RobotekOrleans/CFR2027/Project gestion/functional analysis/Capella/[OAB] Operational Entities.jpg

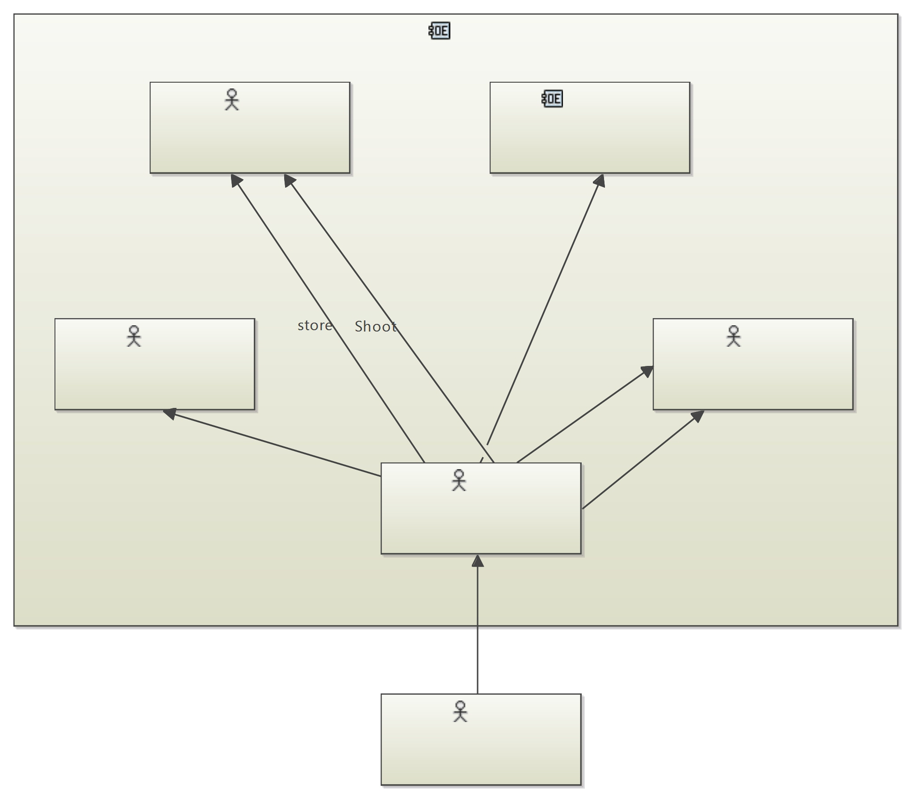
Project gestion/functional analysis/Capella/[OAB] Operational Entities.jpg
