RobotekOrleans/CFR2027/Project gestion/Functionnal Analisys/Project_gestion_OAB.png

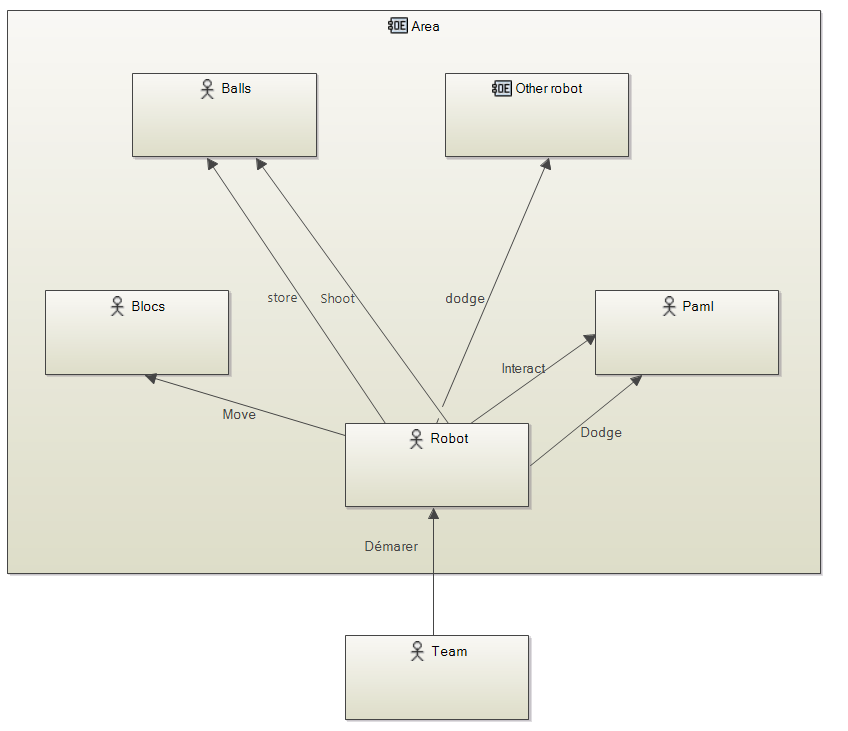
Project gestion/Functionnal Analisys/Project_gestion_OAB.png
