RobotekOrleans/CFR2027/README.md

# French Robotics Cup — Robotek Orléans

## About

This project was initiated by Robotek Orléans to design and build an autonomous robot for the French Robotics Cup (Coupe de France de Robotique), organized under the Eurobot framework.

The goal of the project is to participate at the eurobot competition, for that we need to build a fully autonomous robot capable of performing specific tasks defined in the official rules. The organizers grant complete freedom regarding the robot's structure, mechanical design, and actuation systems. The first requirement is to successfully pass the homologation phase by adhering strictly to the official competition regulations.

- Project Manager: Maxime Fabre

---

## The Robot

The robot features a square-shaped base chassis.

WIP Full Assembly

### Getting Started

1. Connect the battery to the main power connector.

2. The robot will power on and start up automatically.

---

## Repository Structure

The project files are structured as follows:

- [regulation-file](./Regulations%20file/) — Rules, documentation, and resources provided by the Eurobot / French Robotics Cup organizers.

- [Project management](./Project%20management/) — Project tracking, planning, risk analysis, and management resources.

- [Software](./Software/) — Embedded source code, control algorithms, software architecture, and setup guides.

- [Hardware](./Hardware/) — CAD models, 3D printing files, PCB designs, and electrical schematics.

---

## Team & Section Leads

- Project Manager: Maxime Fabre

- Software Lead: Maxime Fabre

- Hardware Lead: Thibaut Martin

- Project Management Lead: Mickaël Borges
