RobotekOrleans/CFR2027/Hardware/README.md

# Hardware - Robotek Orléans

## About

This directory contains the complete hardware development files for the robot, covering its full mechanical structure, electrical schematics, and design decisions.

- Hardware Team Lead: Thibaut Martin

---

## Robot

WIP Full Assembly

## Directory Structure

The Hardware repository is organized into three main categories:

### 1. Mechanical Assembly ([mechanical](./mechanical/) )

Contains images and descriptions of the physical assembly, along with material selections and technical justifications for the structural design choices.

- Section Lead: Thibaut Martin

### 2. CAD & 3D Modeling ([CAD](./cad/) )

Contains 3D assembly models and printable components. 3D modeling enables rapid prototyping of complex geometries with adaptable strength based on material choice and infill settings.

- Section Lead: Mickaël Borges

### 3. Electronics & Schematics (([electronics](./electronics/) ))

Contains electrical schematics, wiring diagrams for the mobile base and actuators, as well as custom PCB layout files.

- Section Lead: Ryan Gedoir
