RobotekOrleans/CFR2027/Hardware/CAO/README.md

# CAD & Hardware - Robotek Orléans

## About

This section contains all 3D CAD modeling files for the robot's mechanical components. 3D modeling allows us to visualize the design clearly, check for potential mechanical constraints, and identify any assembly issues prior to manufacturing.

### Directory Structure

* **`full-assembly/`** *(or `name/`)* — Contains the complete 3D assembly model of the robot.
* **Subfolders** — Dedicated directories for each individual mechanical component and subsystem.

### CAD & 3D Printing Setup

* **CAD Software:** Autodesk Fusion 360

* **3D Printer:** Bambu Lab X1 Carbon

* **Materials:** PLA & PETG (the specific filament used for each component is noted in its description)
---

## Components

### Standoffs (`Standoffs/`)

The robot structure relies on 4 main pillars, held together by threaded rods running through their center. Custom PLA pillars were 3D printed to distribute the structural load across a larger surface area compared to the threaded rods alone.

* **Location:** `Standoffs/`
* **Material:** PLA
* **Filament Used:** ~239.6 g

---

### Motor Mounts (`Motor_support/`)

The robot is driven by 4 motors. Custom PLA mounting brackets were designed and 3D printed to secure the motors to the frame.

* **Location:** `support-moteur/`
* **Material:** PLA
* **Filament Used:** ~72.6 g

---

### Pump Mounts (`support-pompe/`)

The robot uses 4 vacuum/air pumps. Dedicated mounting brackets were 3D printed to securely fasten the pumps to the structure.

* **Location:** `support-pompe/`
* **Material:** PLA
* **Filament Used:** N/A *(To be determined)*
