RobotekOrleans/CFR2027/Software/Liste des pins ESP32.odt

Branchement ESP32

- Capteurs ultrasons : 5 broches.

4 Echo sur GPIO 34, 35, 36, 39 : input only

1. Trigger pour tous les capteurs : GPIO 23
- Ponts en H : 10 broches. GPIO 27, 25, 18, 21 (PWM 1 à 4), GPIO 26, 33, 19, 22 (DIR 1 à 4), GPIO 13 (STBY commun)
- Encodeurs moteurs : 4 broches.

1 seule phase par encodeur pour connaitre la vitesse, le sens de rotation on le connait déjà. GPIO 4, 14, 32, 15

- Communication Pi 4 : 2 broches (UART TX/RX).

GPIO 16 (RX2), GPIO 17 (TX2)

Total = 20 broches.
