RobotekOrleans/CFR2027/Report/Personal_Feedback_n1_Thibaut_MARTIN.docx

# Personal Feedback n°1

# Task completed

## Project specifications

With Rayan I highlighted all the project’s specification and organised them in a table. To specify every function we named them and split them in two : Critical function and Principal function. With that everyone in the project’s can effectively know what our robot must do and can do.
