RobotekOrleans/CFR2027/Project management/Report/grille eval PDR 4A S7 GPSE template(1).xlsx

 |  | Débutant |  | Novice | 0-6 | 4A PDR Projet GPSE S7 (ver : 16/10/2026)
 |  | En développement |  |  | 7-11 | Projet :
 |  | Compétent |  |  | 12-15 | Tutor:
 |  | Avancé |  |  | 16-20 | Commentaires
Elèves |  | Elève A | Elève B | Elève C | Elève D
C4 : Gérer un développement projet dans une approche système
Analyser le besoin opérationnel
● | Compréhension fine des attentes du client / du cas d'usage / du cahier des charges
Établir un cahier des charges fonctionnel
● | Hiérarchisation pertinente des fonctionnalités du projet
● | Dimensionnement exhaustif des fonctionnalités et contraintes
● | Prise en compte pertinente des contraintes écologiques, sociétales et normatives du produit
● | Elaboration contractuelle d'une matrice de conformité
Gérer les risques (projet)
Planifier un développement projet (organisation, livrables et jalons)
● | Description claire des étapes du projet
● | Positionnement précis des jalons (liens entre étapes et livrables)
● | Description détaillée des livrables attendus en fin de projet
Assurer un suivi de projet
● | Organisation hiérarchisée des documents et du suivi
Promouvoir le projet
● | Mise en avant convaincante des innovations et/ou des points clés (HVA)
● | Présentation professionnelle de l'argumentaire
● | Respect strict du format imposé
● | Répartition adaptée du temps de parole
 |  | Débutant |  | Novice | 0-6 | 4A PDR Projet GPSE S7 (ver : 16/10/2026)
 |  | En développement |  |  | 7-11 | Projet :
 |  | Compétent |  |  | 12-15 | Tutor:
 |  | Avancé |  |  | 16-20 | Commentaires
Elèves |  | Elève A | Elève B | Elève C | Elève D
 |  | 0-6 | 0-7 | 0-8 | 0-9
C2 : Intégrer des systèmes matériels
Construire le schéma-bloc fonctionnel du système
● | Découpage pertinent du système, éventuellement en sous projets puis, en fonctions
● | Identification correcte des flux entre blocs fonctionnels
● | Dimensionnement correct des flux entre blocs fonctionnels
● | Présentation formalisée du sytème focntionnel (FAST, diag fonctionnel, Capella,..)
Valider une réponse technique
● | Evaluation pertinente des critères de choix
● | Recueil exhaustif des arguments techniques
● | Analyse critique des impacts écologiques et sociétaux de la solution technique
Analyser les risques de défaillances et de sécurité
Rédiger un dossier d’architecture du système |  |  |  |  |  | à remplir par le tuteur
Commentaire général
Développer des briques technologiques |  | Novice |  | Novice | C1 | 4A PDR Projet GPSE S7 (ver : 16/10/2026)
Intégrer des systèmes matériels |  | En développement |  |  | C2 | Projet : CFR2027
Traiter des données numériques |  | Compétent |  |  | C3 | Tutor: Corentin Bunel
Gérer un développement projet dans une approche système |  | Avancé |  |  | C4
Elève A |  |  |  |  |  | Maxime Fabre
AC1 | Rédiger un dossier d’architecture du système |  |  |  | C2
AC2 | Programmer dans un langage informatique |  |  |  | C3
AC3 | Acquérir des données numériques/brutes |  |  |  | C3
AC4 | Exploiter des techniques de computer vision |  |  |  | C3
AC5
AC ?
Elève B |  |  |  |  |  | Ryan Guedoir
AC1 |  |  |  |  | Cx
AC2
AC3
AC4
AC5
AC ?
Elève C |  |  |  |  |  | Thibaut Martin
AC1 |  |  |  |  | Cx
AC2
AC3
AC4
AC5
AC ?
Elève D |  |  |  |  |  | Mickaël Borges
AC1 | Concevoir une carte électronique |  |  |  | C1
AC2 | Assembler le système (modes d’interaction / de communication) |  |  |  | C2
AC3 | Valider le prototype |  |  |  | C2
AC4 | Planifier un développement projet (organisation, livrables et jalons) |  |  |  | C4
AC5
AC ?
Liste des HVA :
1 | Avancer
2 | Se repérer
3 | Détecter les obstacles
