RobotekOrleans/CFR2027/Hardware/cad/battery-holder/Battery-holder.png

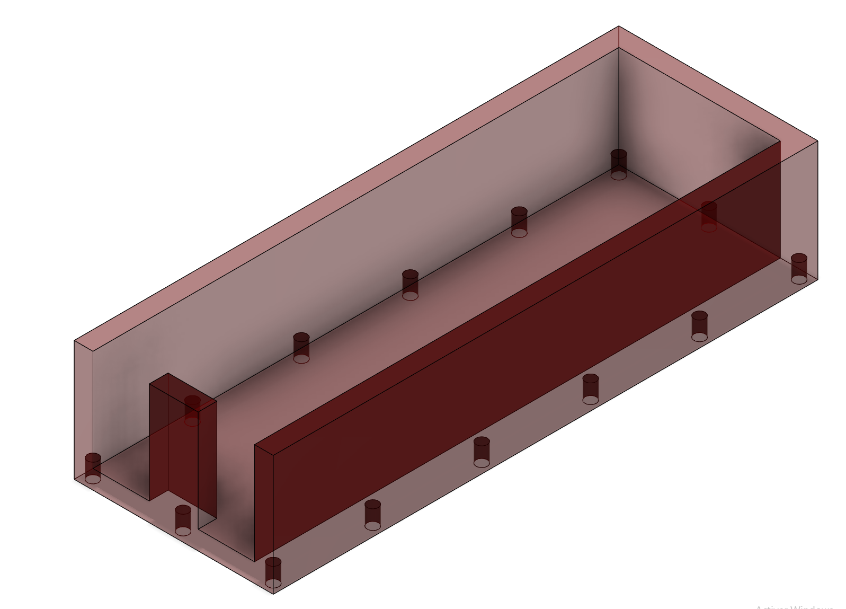
Hardware/cad/battery-holder/Battery-holder.png
