RobotekOrleans/CFR2027/Project gestion/CFR2027 BIS/[MCB] Capabilities.jpg

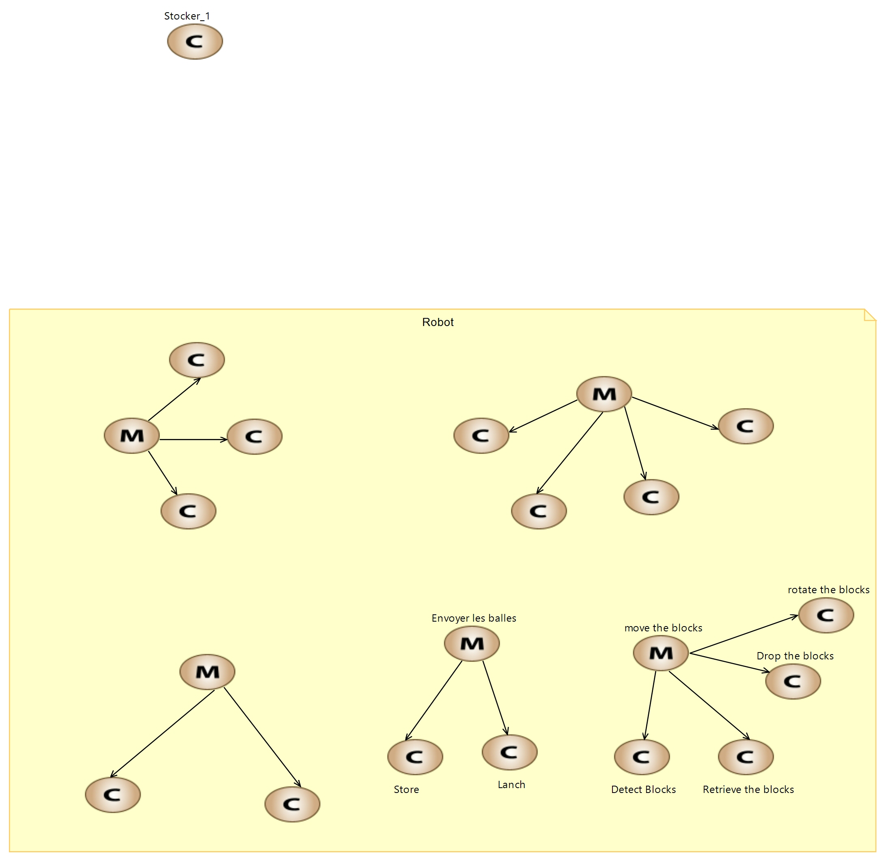
Project gestion/CFR2027 BIS/[MCB] Capabilities.jpg
