RobotekOrleans/CFR2027/Project gestion/functional analysis/Capella/[SAB] Structure.jpg

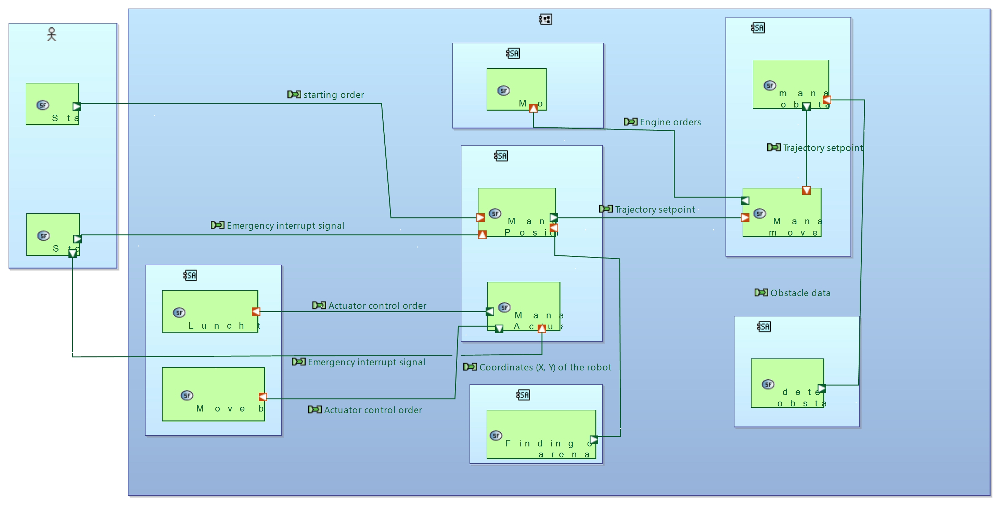
Project gestion/functional analysis/Capella/[SAB] Structure.jpg
