RobotekOrleans/CFR2027/Project gestion/Functionnal Analisys/Project_gestion_MCD.png

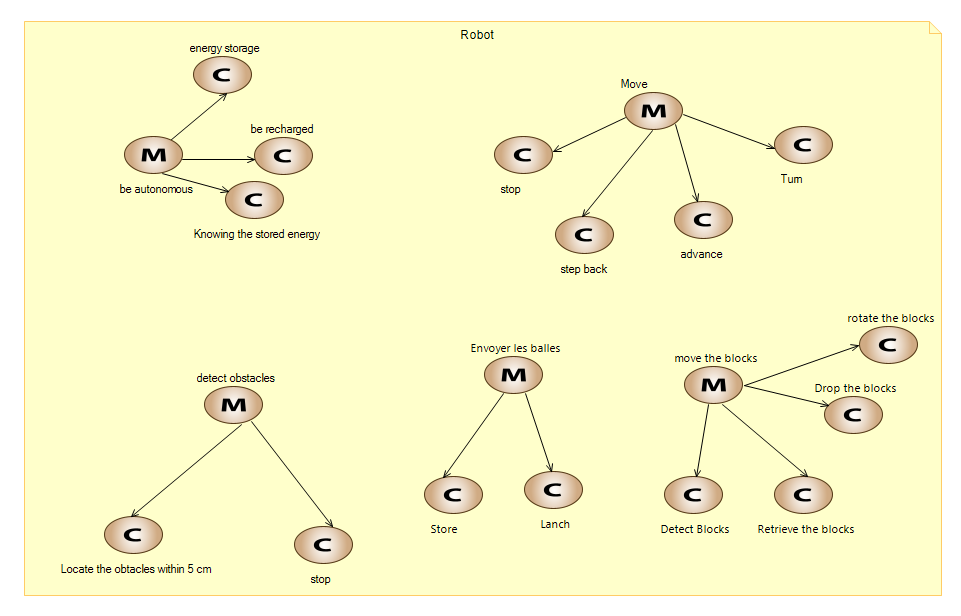
Project gestion/Functionnal Analisys/Project_gestion_MCD.png
