RobotekOrleans/CFR2027/Project gestion/Functionnal Analisys/Project_gestion_SAB.png

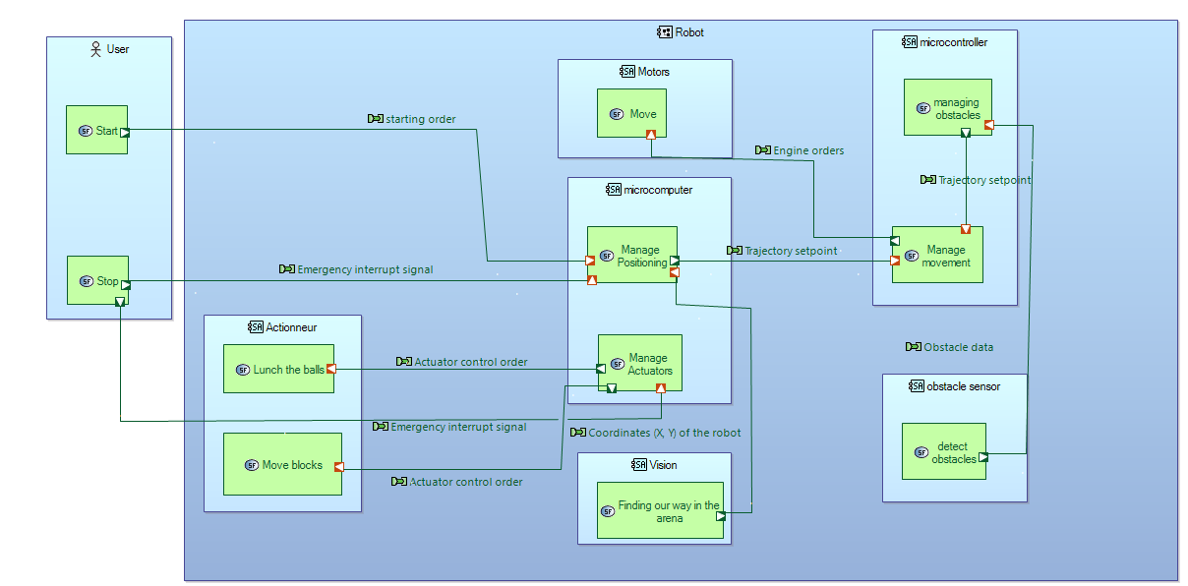
Project gestion/Functionnal Analisys/Project_gestion_SAB.png
