RobotekOrleans/CFR2027/Project gestion/Ganttproject/GanttProject_CFR2027.png

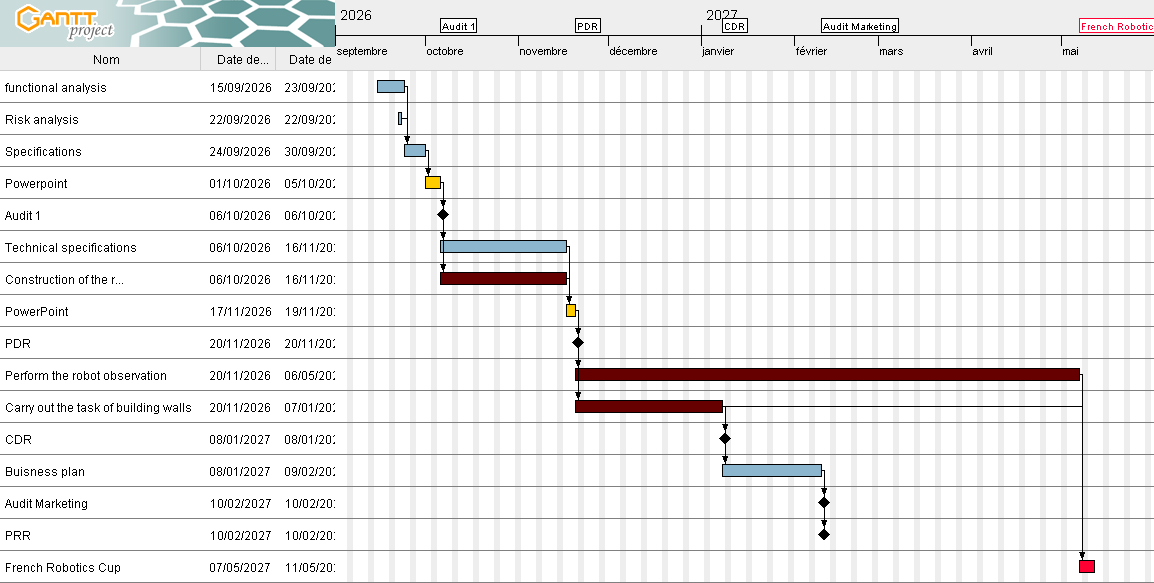
Project gestion/Ganttproject/GanttProject_CFR2027.png
