RobotekOrleans/CFR2027/Project management/functional analysis/Capella/[PAB] Structure.png

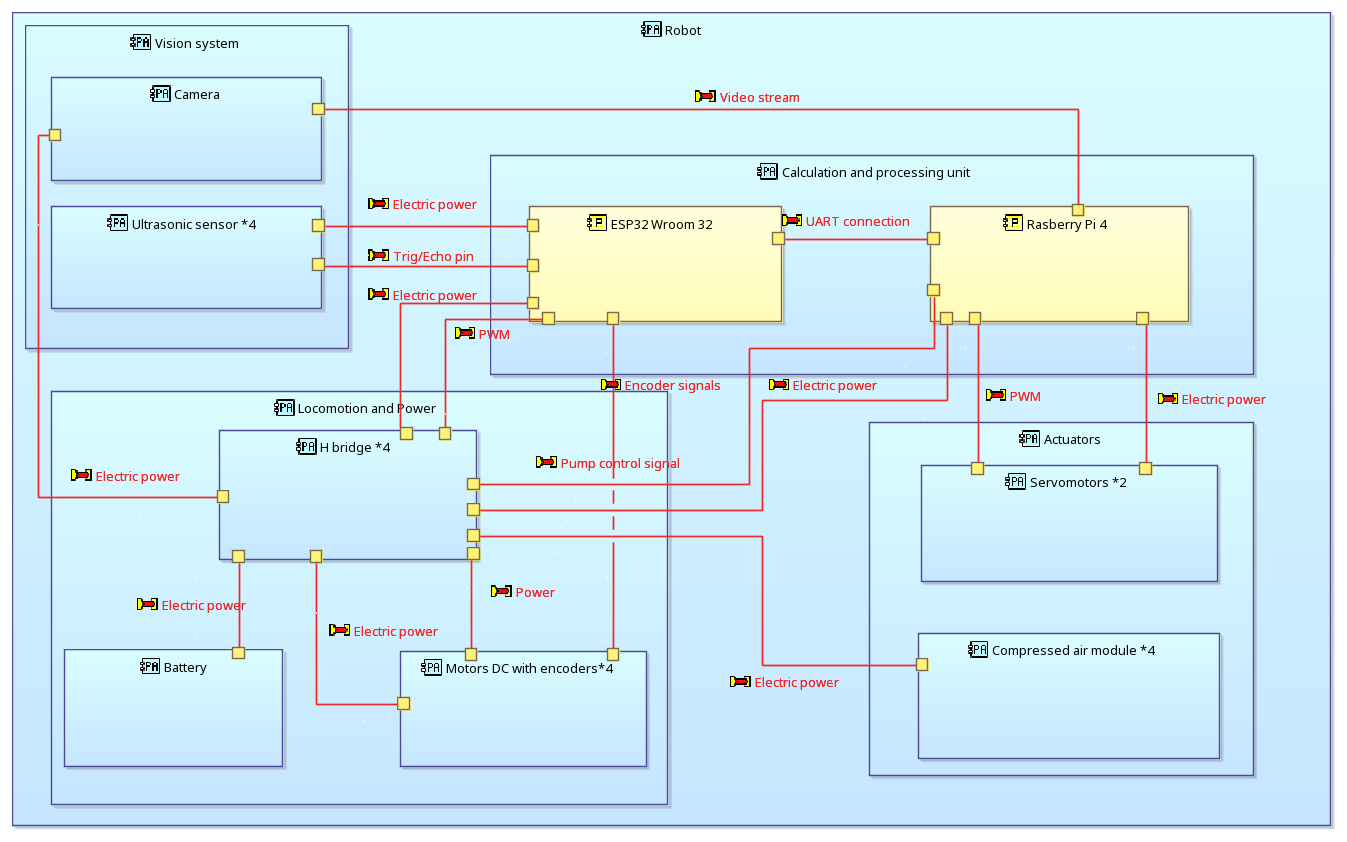
Project management/functional analysis/Capella/[PAB] Structure.png
