RobotekOrleans/CFR2027/Project management/functional analysis/Capella/[SAB] Structure.png

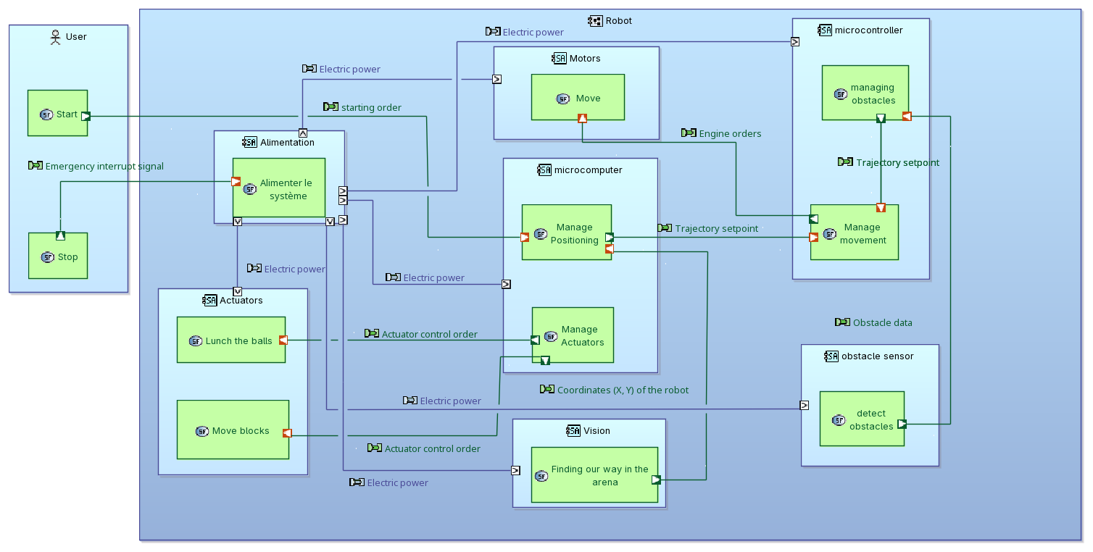
Project management/functional analysis/Capella/[SAB] Structure.png
