RobotekOrleans/CFR2027/Project gestion/Functional_specification.ods

ID | Technical Function Name | Detailed Description | Allocated Components | Language / Technology | Input Flow | Output Flow | Criterion (units) | Value | Tolerance | Priority
FP1 | Move | The robot must move autonomously and multidirectionally | Microcontroller board | C++ | Movement command | PWM signal |  |  |  | P1
 |  |  | 4 DC motors | Electromechanical | PWM signal | Rotation | Rotation speed (rad/s) | 6,25 rad/s | ±0,5 rad/s
 |  |  | 4 Multidirectional wheels | Mechanical | Rotation | Translation | Movement speed (m/s) | 0,25 m/s | ±0,1 m/s
 |  |  | H-bridge | Power electronics | PWM signal + Energy (12V) | 6V voltage
FP2 | Detect an obstacle | The robot must be able to detect an obstacle and stop accordingly | Microcontroller board | C++ | Digital signal | Stop command | Reaction time (ms) | 10 ms | ±2 ms | P1
 |  |  | Ultrasonic sensors | Electronic | Onde de retour | Digital signal | Detection distance (cm) | 5 cm | ±2 cm
FP3 | Power the robot | The robot must be able to be self-powered during a match | Battery | Power electronics | Energy | 12V/5V voltage | Operating time (s) | Minimum 200 s |  | P1
 |  |  |  |  |  |  | Capacity (mAh) | Minimum 3000 mA/h
FP4 | Locate itself | The robot must read QR codes/Tags to locate itself in the arena or identify game elements | Microcontroller board | Python | Read command |  |  |  |  | P1
 |  |  | Camera | Optical / Digital |  | Pixel matrix | ArUco Tag detection | /
 |  |  |  |  |  |  | Reading distance (cm) | 100 cm | ±10 cm
FP5 | Move blocks | The robot must be able to move, rotate and arrange blocks | Microcontroller board | Python | / | PWM signal |  |  |  | P2
 |  |  | Servomotors | Electromechanical | PWM signal | Rotation | Rotation (°) | 180 ° | ±5 °
 |  |  |  |  |  |  | Gripper opening (mm) | Minimum 115 mm
 |  |  |  |  |  |  | Lifting height (mm) | Minimum 350 mm
 |  |  | Compressed air module | Pneumatic | Electrical signal | Linear movement | Gripping pressure (bars)
FP6 | Shoot balls | The robot must be able to shoot balls into the enemy castle | Carte microcontroleur | Python | Shoot command | PWM signal |  |  |  | P2
 |  |  | Motor | Electromechanical | PWM signal | Rotation | Rotation speed (rad/s) | 150 rad/s | ± 10 rad/s
 |  |  |  |  |  |  | Accepted diameter (mm) | 45 mm | ±1 mm
 |  |  |  |  |  |  | Shooting range (m) | 1,5 m | ±0,5 m
FP7 | Elevate the Graal | The robot must take the Graal and hoist it on top of itself | Microcontroller board | Python | Lift command | PWM signal |  |  |  | P2
 |  |  | Servomotors | Electromechanical | PWM signal | Rotation | Rotation (°) | 180 ° | ±5 °
 |  |  |  |  |  |  | Final elevation height (mm) | 350 mm | ±50 mm
FC1 | Emergency stop | The robot must be able to be emergency stopped | "Mushroom" push button | Interruption | Physical pressure | Power cut | Time before stop (ms) | Maximum 500 ms |  | P1
 |  |  |  |  |  |  | Distance before stop (cm) | Maximum 3 cm
FC2 | Respect dimensions | The robot must respect dimensions | Max undeployed dimension | / |  |  | Perimeter (mm) | Maximum 1200 mm |  | P1
 |  |  |  |  |  |  | Height (mm) | Maximum 350 mm
 |  |  | Max deployed dimension |  |  |  | Perimeter (mm) | Maximum 1400 mm
 |  |  |  |  |  |  | Height (mm) | Maximum 350 mm
