RobotekOrleans/CFR2027/Project gestion/AMDEC_ROBOTICS_FRENCH_CUP_2027.xlsx

Sheet: FMEA Analysis
ROBOTICS FRENCH CUP 2027 — PROJECT FMEA ANALYSIS
Rating scale (1 to 4): F = Frequency, S = Severity, D = Detectability, Criticality C = F × S × D (Max: 64)
Category | Item / Function | Failure Mode | Effect on Project / Match | Possible Cause | F | S | D | Criticality (C) | Action / Prevention Plan
Technical | Certification | Non-compliance of the collision avoidance system | Unable to take part in the qualifying rounds (disqualification) | Poorly calibrated sensors, blind spot in the field of view | 3 | 4 | 4 | 48 | Homologation tests in real conditions (beacons, opposing robots) 1 month before the event.
Technical | Moving base | Wheel slip or loss of odometry | Trajectory drift, collision, zero points scored | Dust on the table, tyre wear, faulty encoder | 3 | 3 | 2 | 18 | Clean the wheels before every match, mechanical re-alignment against the borders.
Finance & Logistics | Procurement | Late delivery of key components | Critical delay to the testing and programming schedule | Supplier stock-out, customs delays, global shortage | 2 | 2 | 4 | 16 | Identify equivalent components (plan B) and place critical orders by late 2026.
Events & HR | Teams / Skills | Departure or unavailability of a key member | Loss of knowledge, major development delay | Study/work load, illness, internal conflict | 2 | 3 | 2 | 12 | Pair up people on each area (mech, elec, software) and make documentation on Git/Wiki mandatory.
Technical | Powering | Short circuit or empty LiPo battery | Robot immobile, fire risk, forfeit | No BMS, unsuitable fuse, poor charge management | 2 | 4 | 2 | 16 | Install a BMS and an accessible circuit breaker, and provide 3 checked battery sets.
Technical | Actuators / Board | Burnt-out component (motor driver, microcontroller) | Loss of a key function or complete robot shutdown | Overcurrent, poor heat dissipation, electric shock | 2 | 3 | 2 | 12 | Duplicate critical electronic boards and motors (spare parts).
Finance & Logistics | Budget | Budget overrun or sponsorship cancelled | Unable to order key parts or travel | Poor cost estimate, partner withdrawal | 2 | 3 | 2 | 12 | 15% safety margin in the initial budget + regular follow-ups with sponsors.
Technical | Dimensions / Weight | Robot out of size limits at static inspection | Rejected at static homologation | Last-minute parts added without checking the starting area | 2 | 4 | 1 | 8 | Systematic weighing and measuring in CAD and in reality after every modification.
Finance & Logistics | Transportation | Robot breakage or damage in transit | Robot damaged on arrival at the competition site | Insufficient packaging, shock during transport | 2 | 3 | 1 | 6 | Build a custom-made, cushioned flight case for transporting the robot and the stand.
Events & HR | On-site scheduling | Late for a match call | Forfeit of the round (0 points awarded) | Poor time management in the booths, repairs taking too long | 1 | 4 | 1 | 4 | Time the preparation procedures and appoint a dedicated team leader for scheduling.
Events & HR | Booth Management | Loss of tools or forgetting critical equipment | Wasted time, repairs impossible in the booths | Disorganised booth, no departure checklist | 2 | 2 | 1 | 4 | Draw up an inventory checklist before departure and appoint a booth manager.

Sheet: Dashboard
RISK SUMMARY AND STATISTICS
Indicator | Value
Total number of risks identified | 11
Critical risks (C ≥ 20) | 1
Moderate risks (12 ≤ C < 20) | 6
Low risks (C < 12) | 4
