RobotekOrleans/CFR2027/Project management/Planned budget/Dépenses.xlsx

Sheet: Général
Produit | Coûts unitaire | nombre | Lien d'achat |  | Datasheet
Support ventouse + ventouse | 11.99 | 0
Roue | 24.23 | 0
Rasberry pi4 | 0 | 1 |  | Fournit par Robotek
ESP 32 wroom | 0 | 1 |  | Fournit par Robotek | https://documentation.espressif.com/esp32-wroom-32_datasheet_en.pdf
Pompe | 8.29 | 5 | https://www.gotronic.fr/art-mini-pompe-a-vide-370-fit0801-34166.htm
 |  | 4 | https://www.gotronic.fr/art-motoreducteur-encodeur-fit0521-27897.htm
Ponts en H | 0 | 4 |  | Fournit par Robotek
Camera | 0 | 1 |  | Fournit par Robotek
Ultrasonic sensors | 0 | 4 |  | Fournit par Robotek
Servomotors | 0 | 2 |  | Fournit par Robotek
Betterie | 0 | 1 |  | Fournit par Robotek
Total : | 41.45

Sheet: Polytech
Liste des composant commander par Polytech
 | Liens | Site | Nom | Qd | Prix par unité | Prix | Souhaiter | Nb à commander | Prix total
 | https://www.gotronic.fr/art-mini-pompe-a-vide-370-fit0801-34166.htm | gotronic | Mini pompe à vide 370 FIT0801 | 1 | €8.90 | €8.90 | 5 | 5 | €44.50

Sheet: Robotek
Liste des composants commander par Robotek orleans
 | Liens | Site | Nom | Qd | Prix par unité | Prix | Souhaiter | Nb à commander | Prix total
 | https://fr.aliexpress.com/item/4001314473291.html?scm_id=1007.40050.354490.0&scm-url=1007.40050.354490.0 | Aliexpress | Moteur encodeur | 1 | €10.49 | €10.49 | 4 | 4 | €41.96 | 95.37
 | https://fr.aliexpress.com/item/1005008686230991.html?curPageLogUid=0qIJv1078DbE | Aliexpress | Roue omnidirectionnelle | 4 | €0.24 | €16.99 | 4 | 1 | €16.99
 | https://fr.aliexpress.com/item/1005010529232254.html?curPageLogUid=xnN2CBEHq8ka | Aliexpress | Ventouse | 1 | €0.12 | €8.49 | 4 | 4 | €33.96
 | https://fr.aliexpress.com/item/1005013297231787.html?tracking_id=ODAyLWctMg%3D%3D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 | Aliexpress | tuyau pour ventause | 1 | €2.46 | €2.46 | 1 | 1 | 2.46

Sheet: Moteur
 | Site | Référence | tension d'alimentation (v) | Couple (Kg.cm) | Intensité de démarage (A) | Encodeur | Vitesse (rpm) | Prix (€) | Compatibilité avec LN298N | Note | Liens
Moteur | Gotronic | FIT0520 | 6 | 3.6 | 2.7 | oui | 300 | 21.50 € | oui | 10 | https://www.gotronic.fr/art-motoreducteur-encodeur-fit0520-27896.htm
Moteur | Gotronic | FIT0522 | 6 | 6.5 | 3 | oui | 100 | 21.50 € | oui | 5 | https://www.gotronic.fr/art-motoreducteur-encodeur-fit0522-27898.htm
Moteur | Gotronic | FIT0521 | 6 | 10 | 3.2 | oui | 210 | 21.50 € | non | 0 | https://www.gotronic.fr/art-motoreducteur-encodeur-fit0521-27897.htm
Moteur | Gotronic | 37Y3530-43.8 | 12 | 18 | 5.5 | oui | 251 | 26.30 € | non | 0 | https://www.gotronic.fr/art-motoreducteur-encodeur-37y3530-43-8-20605.htm
Moteur | Gotronic | 37Y3530-131 | 12 | 45 | 5.5 | oui | 83 | 26.30 € | non | 0 | https://www.gotronic.fr/art-motoreducteur-encodeur-37y3530-131-20604.htm
Moteur | Gotronic | FIT0450 | 6 | 0.8 | 2 | oui | 160 | 8.90 € | oui | 5 | https://www.gotronic.fr/art-kit-moteur-encodeur-fit0450-27583.htm
Moteur | Gotronic | 4755 | 12 | 34 | 5.5 | oui | 100 | 69.50 € | non | 0 | https://www.gotronic.fr/art-motoreducteur-encodeur-4755-28113.htm
Moteur | Aliexpress | JGA25-370 | 6 | 9 | 1 | oui | 620 | 9.99 € | oui | 8 | https://fr.aliexpress.com/item/4001314473291.html?scm_id=1007.40050.354490.0&scm-url=1007.40050.354490.0
Moteur | Aliexpress | sGM25-370 | 6 | 2.2 | 1 | oui | 282 | 6.29 € | oui | 8 | https://fr.aliexpress.com/item/1005009095909930.html?curPageLogUid=pIGJIPpt6fA2
 | Site | Référence | tension d'alimentation (v) | Vide min (kpa) | Débit (L/min) | Diamètre de sortie (mm) | Prix (€) |  |  | Note | Liens
Pompe | Gotronic | 370 FIT0801 | 5 | -58 | 2.2 | 4.3 | 6.90 € |  |  | 8 | https://www.gotronic.fr/art-mini-pompe-a-vide-370-fit0801-34166.htm
Pompe | AliExpress | VN-2707PM | 6 | -50 | 3 | 4.3 | 5.19 € |  |  | 6 | https://fr.aliexpress.com/item/1005006476509817.html?pdp_ext_f=%7B"order"%3A"12"%2C"eval"%3A"1"%2C"fromPage"%3A"search"%7D&pdp_npi=6%40dis%21EUR%215.19%215.19%21%21%215.69%215.69%21%400b15834e17925712533892786e0ea1%2112000037342014469%21sea%21FR%210%21ABX%211%210%21n_tag%3A-29910%3Bd%3Afda5f202%3Bm03_new_user%3A-29895&curPageLogUid=RhHnMSGfmdep&utparam-url=scene%3Asearch%7Cquery_from%3A%7Cx_object_id%3A1005006476509817%7C_p_origin_prod%3A&search_p4p_id=202610210127336588276842480480000094386_1 (https://fr.aliexpress.com/item/32890830349.html)
Pompe | AliExpress | 370C-22155 | 6 | -60 | 3 | 4.3 | 3.69 € |  |  | 6 | https://www.aliexpress.us/item/3256805770721534.html
 |  |  |  | Vide min requis = -30kpa
 | Site | Référence | Diamètre d'entrée (mm) | Diamètre de sortie (mm) | Prix (€) |  |  |  |  | Note | Liens
Ventouse

Sheet: Pompe
Site | Nom | tension d'alimentation (v) | Aspiration (kpa) | Intensité de démarage (A) | Débit (L.min) | diamètre d'entré (mm) | Prix (€) | LN298N | Note | Liens
Gotronic | FIT0801 | 5 | -58 | 0.5 | 2.2 | 4.3 | €6.90 | oui |  | https://www.gotronic.fr/art-mini-pompe-a-vide-370-fit0801-34166.htm

Sheet: Forced component
Name | Reference | Voltage (V) | Intensity (mA) | Logic level (v) | weight (g) | measurement range (cm) | Rzsolution (px) | freq (fps)
H- bridge | Ln298N | 5 to 50 | 3000 | 4.7 | NA | NA | NA | NA
Power Cell | lipo 3s batterie lipo 3s lipo battery | 11.1 | 4200 | NA | 280 | NA | NA | NA
Ultrason sensor | HC-SR04 | 5 | 15 | 3 | NA | 2 à 400 | NA | NA
Camera | Trust Exis 17003-02 | 5 | 500 | NA | NA | NA | 640x480 | 30
