RobotekOrleans/CFR2027/Project management/Planned budget/Planned budget.xlsx

Category | Component type | Component name | Unit price (€) | Qty needed | Purchase price (€) – per lot | Purchase qty (per lot) | Purchased by | Total (€) | No. of lots to buy | Actual purchase cost (€)
Sensor | Camera | Camera | 0.00 € | 1 | 0.00 € | 1 | Robotek | 0.00 € | 0 | 0.00 €
Sensor | Ultrasonic | HC-SR04 | 0.00 € | 4 | 0.00 € | 1 | Robotek | 0.00 € | 0 | 0.00 €
Sensor | PCB | Sensor PCB | 2.40 € | 5 | 12.00 € | 5 | Robotek | 12.00 € | 1 | 12.00 €
Actuator | Pump | Pump | 8.29 € | 5 | 8.29 € | 1 | Polytech | 41.45 € | 5 | 41.45 €
Actuator | Suction cup | Silicone suction cup | 2.1225 € | 4 | 8.49 € | 4 | Robotek | 8.49 € | 4 | 33.96 €
Actuator | Tubing | Suction cup tubing | 2.46 € | 1 | 2.46 € | 1 | Robotek | 2.46 € | 1 | 2.46 €
Actuator | Main board | Raspberry Pi 4B (4 GB) | 90.00 € | 1 | 90.00 € | 1 | Robotek | 90.00 € | 0 | 0.00 €
Actuator | Servo motor | MG996R | 0.00 € | 2 | 0.00 € | 1 | Robotek | 0.00 € | 0 | 0.00 €
Actuator | PCB | Actuator PCB | 2.40 € | 5 | 12.00 € | 5 | Robotek | 12.00 € | 1 | 12.00 €
Actuator | SD Card 32Gb | SD Card | 18.49 € | 1 | 18.49 € | 1 | Polytech | 18.49 € | 0 | 0.00 €
Chassis (mechanical) | Board | Plywood / MDF | 8.00 € | 1 | 8.00 € | 1 | Robotek | 8.00 € | 0 | 0.00 €
Chassis (mechanical) | Threaded rod | M6 | 3.00 € | 4 | 3.00 € | 1 | Robotek | 12.00 € | 0 | 0.00 €
Chassis (mechanical) | Nut | M6 | 0.08 € | 4 | 4.00 € | 50 | Robotek | 0.32 € | 0 | 0.00 €
Chassis (mechanical) | Lock nut | M6 | 0.20 € | 8 | 5.00 € | 25 | Robotek | 1.60 € | 1 | 5.00 €
Chassis (drive) | H-bridge | L298N | 3.198 € | 4 | 15.99 € | 5 | Robotek | 12.79 € | 0 | 0.00 €
Chassis (drive) | Wheel | Omnidirectional wheel | 4.2475 € | 4 | 16.99 € | 4 | Robotek | 16.99 € | 1 | 16.99 €
Chassis (drive) | Motor | FIT0520 | 21.50 € | 4 | 21.50 € | 1 | Polytech | 86.00 € | 4 | 86.00 €
Chassis (drive) | Secondary board | ESP32-WROOM | 0.00 € | 1 | 0.00 € | 1 | Robotek | 0.00 € | 0 | 0.00 €
Consumable | PLA | PLA filament (g) | 0.02 € | 2000 | 20.00 € | 1000 | Robotek | 40.00 € | 0 | 0.00 €
Consumable | Electricity | 3D printing (Wh) | 0.00025 € | 500 | 0.25 € | 1000 | Robotek | 0.12 € | 0 | 0.00 €
Consumable | Tin | Solder (g) | 0.06 € | 500 | 30.00 € | 500 | Robotek | 30.00 € | 0 | 0.00 €
Consumable | Fasteners | Assortment (pieces) | 0.04 € | 500 | 20.00 € | 500 | Robotek | 20.00 € | 0 | 0.00 €
Other | Battery | LiPo 3S 11.1 V 4200 mAh | 34.995 € | 1 | 69.99 € | 2 | Robotek | 34.99 € | 0 | 0.00 €
Human | Team member | Maxime Fabre | 12.31 € | 96 |  |  | — | 1181.76 € | 0
Human | Team member | Ryan Guedoir | 12.31 € | 96 |  |  | — | 1181.76 € | 0
Human | Team member | Thibaut Martin | 12.31 € | 96 |  |  | — | 1181.76 € | 0
Human | Team member | Mickael Borges | 12.31 € | 96 |  |  | — | 1181.76 € | 0
TOTAL (purchases + labor) |  |  |  |  |  |  |  | 5174.75 € |  | 209.86 €
TOTAL Polytech |  |  |  |  |  |  |  | 145.94 € |  | 127.45 €
TOTAL Robotek |  |  |  |  |  |  |  | 301.77 € |  | 82.41 €
Labor (team, at French minimum wage / SMIC) |  |  |  |  |  |  |  | 4727.04 €
