RobotekOrleans/CFR2027/Hardware/cad/battery-holder/battery-holder.stl

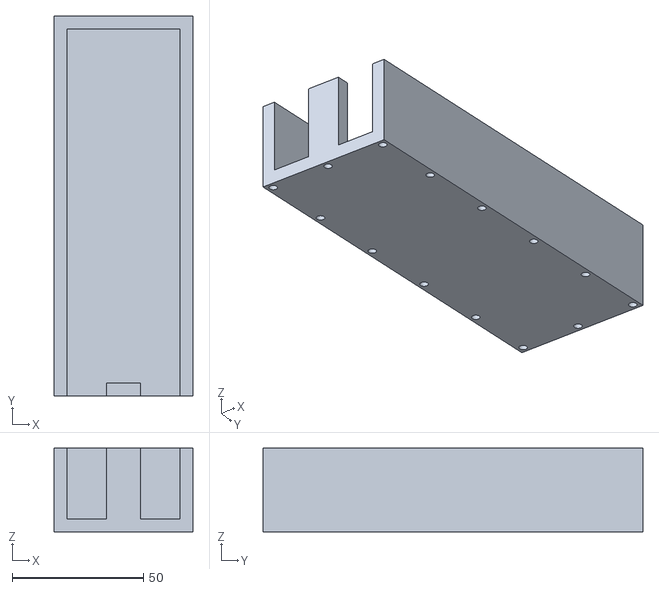
[picture p11: CAD file, 2026-10-21]
Hardware/cad/battery-holder/battery-holder.stl
53.0 x 145.0 x 32.0
