RobotekOrleans/CFR2027/Hardware/cad/Standoffs/Standoffs.stl

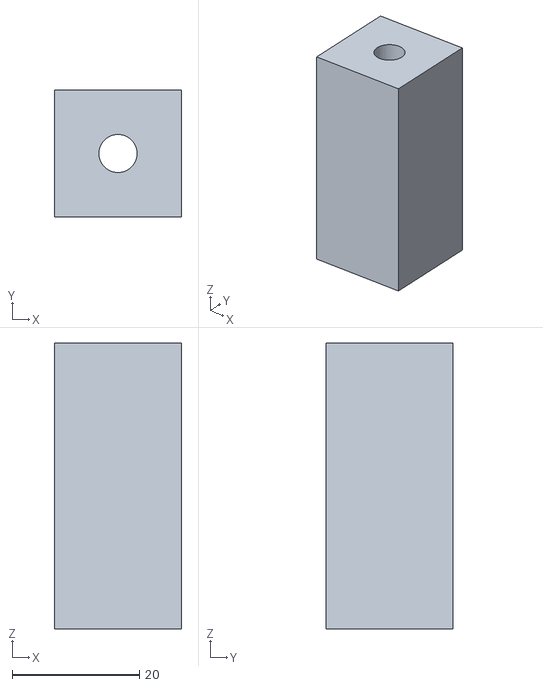
[picture p12: CAD file, 2026-10-21]
Hardware/cad/Standoffs/Standoffs.stl
20.0 x 20.0 x 45.0
