RobotekOrleans/CFR2027/Hardware/CAO/Motor support/Motor Support.stl

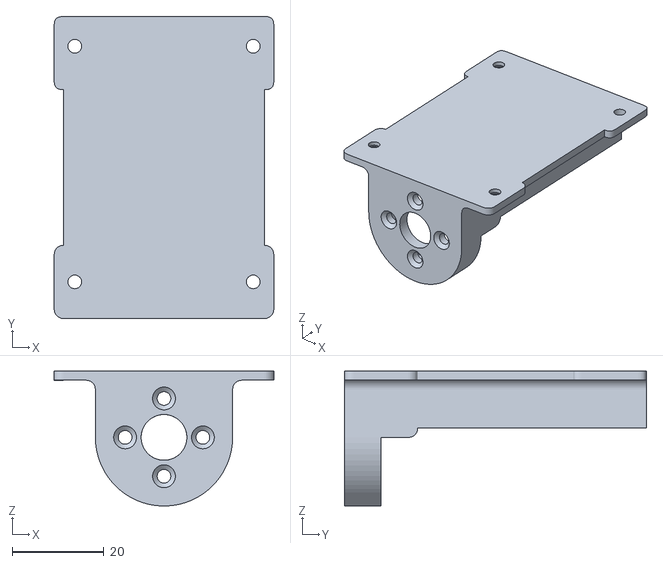
[picture p13: CAD file, 2026-10-21]
Hardware/CAO/Motor support/Motor Support.stl
48.0 x 66.0 x 29.5
