RobotekOrleans/CFR2027/(list of files, cad)

Other CAD files:
Hardware/cad/Motor_support/Support_moteru5.gcode.3mf
Hardware/cad/battery-holder/battery-holder.gcode.3mf
Hardware/CAO/Motor support/Support_moteur.gcode.3mf
