RobotekOrleans/CFR2027/Test Sheet.docx

Test Sheet

Sheet P – Prerequisites

Sheet P1

Objective: Check the perimeter of the convex hull of the robot’s vertical projection in its starting configuration.

Precondition: Robot powered on, in starting configuration (actuators retracted, cannonballs loaded, cord inserted), on a flat floor.

Procedure:

  1. Go around the robot with a taut string, at the height where it is widest, enclosing everything that protrudes (sensors, wheels, emergency stop, mast, cables, screws), as the referee would.
  2. Mark the string and measure it laid flat. Repeat 3 times; keep the maximum value.
  3. Cross-check: measure the sides with a ruler and calculate the perimeter of the convex hull.

Acceptance criteria:

- C1 Measured perimeter ≤ 1190 mm (limit 1200 mm, 10 mm margin).
- C2 Difference between string and calculation ≤ 10 mm (otherwise redo the measurement).

Results:

Sheet P2

Objective: Check the maximum perimeter reached during the match, in the least favorable combination of actuators.

Procedure:

  1. List all actuators that change the envelope (suction-cup arm, launcher, Grail elevator…).
  2. Simultaneously place each actuator in its outermost possible position (including in case of a software fault: mechanical stop).
  3. Measure the perimeter as in S-01 (3 measurements, maximum value).
  4. Informative measurement: repeat with a stone held by the robot. If the result exceeds 1400 mm, ask the question on the FAQ before the competition.

Acceptance criteria:

- C1 Maximum deployed perimeter ≤ 1390 mm, mechanical stops included.

Result:

Sheet P3

Objective: Check that at all times neither the robot, nor its actuators, nor the objects it handles exceed 350 mm, except for the planned exceptions.

Procedure:

  1. Measure the robot’s height at rest (excluding the emergency stop and the beacon mast, which are excluded from the limit).
  2. Bring each actuator to its extreme high position (mechanical stop) and measure.
  3. Grasp a stone flat, then vertically, then the Grail; bring the assembly to the transport position and to the highest position; measure the highest point of the object.

Acceptance criteria:

- C1 Robot and actuators: ≤ 345 mm in all positions, including in the construction zone (actuators may never exceed 350 mm).
- C2 Handled objects outside the construction zones and the castle courtyard: ≤ 345 mm.
- C3 The only possible exceedances concern game elements (stones, Grail) in the construction zones and the castle courtyard; the software only allows these positions in those zones (checked in D-06).

Result:

Sheet P4

Objective: Check the presence, type, color, size, position and accessibility of the BAU (emergency stop button).

Procedure:

  1. Measure the diameter of the button head and the height of its top relative to the floor.
  2. Check its position: at the top of the robot, visible, on a clear surface, outside the danger zone (not near an actuator or the launcher).
  3. Strike it with a fist using a quick vertical movement, with the robot in starting configuration and then deployed: the button must be reached without obstruction.
  4. Check that it stays pressed down after being pushed and resets by rotation or pulling.

Acceptance criteria:

- C1 Red button, head diameter ≥ 20 mm (a 40 mm “mushroom” button is recommended).
- C2 Placed at the top of the robot, visible and accessible whatever the configuration.
- C3 Top of the button ≤ 370 mm (limit 375 mm) and protrusion ≤ 25 mm above the regulation height.
- C4 Can be activated with a single vertical punch (5 attempts out of 5).
- C5 Latching button (stays pressed) – internal requirement: a button that returns by itself would restart the robot.

Result:

Sheet P5

Objective: Check the dimensions, height and position of the support intended to receive the opponent’s beacon.

Procedure:

  1. Measure the height of the support’s upper surface relative to the floor, at 3 points.
  2. Check with a level that the upper surface is flat and horizontal.
  3. Measure the cross-section of the mast over the whole height between the top of the robot and the support (smallest inscribed circle, largest circumscribed square).
  4. Locate the center of the robot (intersection of the diagonals of the ground footprint) and measure the distance between this center and the farthest point of the support.
  5. Visually check that the mast is hollowed out as little as possible between 350 mm and its top.

Acceptance criteria:

- C1 Height of the top of the support between 427 and 433 mm at each of the 3 points (rules: 430 ± 5 mm).
- C2 Upper surface flat and horizontal (bubble centered).
- C3 Over the whole height: cross-section containing a circle of Ø ≥ 72 mm and contained within a square of 98 mm side.
- C4 The whole support is within 95 mm of the robot’s center (mandatory: within a circle of Ø 200 mm).
- C5 If a rotating device requires an opening: height < 2 cm and impossible to see through the mast.

Result:

Sheet P6

Objective: Check that the support is solid, opaque, covered with Velcro and contains only what is allowed.

Procedure:

  1. Shine a lamp on the mast from one side and observe from the other: no light must pass through.
  2. Same test with an infrared remote control filmed through the mast by the smartphone camera.
  3. Check that the whole upper surface is covered with Velcro, hook side.
  4. List everything attached on or inside the mast.

Acceptance criteria:

- C1 Mast solid and opaque to visible and infrared light (no light or IR signal detected).
- C2 Upper surface entirely covered with Velcro, hook side.
- C3 The mast carries only detection or telecommunication systems.

Result:

Sheet P7

Objective: Check that the support holds the opponent’s beacon and the ArUco marker without bending or moving.

Procedure:

  1. Measure the height of the support unloaded, then place the 500 g mass (25% margin over 400 g) and measure again after 1 min.
  2. Push the top of the mast sideways with a finger (≈ 2 N) in 4 directions and observe.
  3. Keep the mass (attached to the Velcro) during a complete dynamic test (D-03) and film the mast.

Acceptance criteria:

- C1 Sag under 500 g ≤ 1 mm; height still within 427–433 mm under load.
- C2 No play or movement of the mast relative to the robot.
- C3 The mass does not fall and the mast does not visibly oscillate during the dynamic test.

Result:

Sheet P8

Objective: Check that the marker supplied by the organizers can be placed and that the robot does not use prohibited tags or misleading elements.

Procedure:

  1. Place the marker mock-up on the beacon support.
  2. List all ArUco tags or printed patterns present on the robot.

Acceptance criteria:

- C1 The marker holds on the Velcro, is horizontal and is not hidden by any element of the robot.
- C2 No 4×4 ArUco tag numbered 0 to 50 on the robot; any team tags comply with the ranges 51–70 (blue) / 71–90 (yellow) or are above 90 / of another format.
- C3 No object or graphic imitating a game element (stone, cannonball, Grail) visible on the robot.

Result:

Sheet P9

Objective: Check the space reserved for the organizers’ stickers.

Procedure:

  1. Apply the template on a vertical face of the robot.

Acceptance criteria:

- C1 There is, on a vertical face, a solid, flat and rigid rectangle of at least 100 × 70 mm, free of any element (screw, sensor, cable).

Result:

Sheet P10

Objective: Check that the robot presents no danger and that no part can come off.

Procedure:

  1. Run a gloved hand over all accessible edges and corners.
  2. Check the tightness of all fasteners (lock nuts, thread-locker) and the hold of the printed parts.
  3. Shake the robot (turned upside down above a mat): nothing must fall.
  4. Check the absence of liquids, corrosive, flammable or pyrotechnic products.

Acceptance criteria:

- C1 No sharp edge, point or end of threaded rod accessible (end caps, cap nuts or chamfers).
- C2 All fasteners are locked; nothing falls during the shake test.
- C3 No prohibited substance.
- C4 Cables fastened, no cable hanging outside the robot’s envelope.

Result:

Sheet P11

Objective: Check that only authorized energy sources are used and that the voltage stays below 48 V.

Procedure:

  1. List all sources of stored energy (batteries, springs, elastic bands, compressed air…).
  2. Measure the voltage of the fully charged battery and the highest voltage present in the robot (possible step-up converters).

Acceptance criteria:

- C1 Only authorized sources: chemical batteries, CE cells, springs, elastic bands, compressed air, gravity.
- C2 Maximum measured voltage ≤ 48 V DC (expected: ≈ 12.6 V for a charged 3S LiPo).

Result:

Sheet P12

Objective: Check the conditions imposed on lithium batteries without an integrated BMS.

Procedure:

  1. For each battery: visual inspection (swelling, impact, sleeve, cables, connector) and measurement of each cell.
  2. Check that the battery is in its commercial fireproof bag, including once mounted in the robot.
  3. Check that the charger is suitable (LiPo, balancing, 3S) and is part of the kit presented at homologation.
  4. Check the undervoltage detection device (alarm or software monitoring): simulate a low cell with a laboratory power supply.

Acceptance criteria:

- C1 Original, unmodified batteries with no visible defect; difference between cells ≤ 0.05 V after charging.
- C2 Each battery is permanently in an unmodified commercial fireproof bag, including inside the robot.
- C3 LiPo balancing charger available for homologation.
- C4 Undervoltage detection operational (alert at 3.5 V per cell or higher) – strongly recommended by R1, required internally.

Result:

Sheet P12 (second one, as in the original)

Objective: Limit the risk of fire and electrical failure.

Procedure:

  1. Measure the total current at the most violent start-up (4 motors + pumps + servos) and in normal operation.
  2. Check the presence of a fuse (or circuit breaker) as close as possible to the battery, and its rating.
  3. Check the cross-section of each power conductor relative to the fuse that protects it.
  4. Check the connectors: keyed, no bare conductor, heat-shrink sleeves on solder joints.

Acceptance criteria:

- C1 Fuse or relay present within 10 cm of the battery, rating above the normal current and below the current rating of the smallest cable it protects.
- C2 No bare conductor; battery connector keyed.
- C3 No abnormal heating of the cables after 3 min of intensive operation (by touch, or < 50 °C).

Result:

Sheet P13

Objective: Check the class of lasers.

Condition: If the robot carries a laser (LiDAR, rangefinder, pointer).

Procedure:

  1. List the laser devices and attach the manufacturer’s documentation stating their class (IEC 60825).

Acceptance criteria:

- C1 Class 1 or 1M; or class 2 with the beam never projected outside the playing area and switched off when the robot is not on the playing area.
- C2 Device not disassembled or modified; documentation printed and included in the file (L-02).

Result:

Sheet P14

Objective: Check that the robot is autonomous during the match and can only be started by the cord.

Procedure:

  1. Start the robot in match mode; scan for Wi-Fi networks and Bluetooth devices emitted by the robot.
  2. Check in the RPi software that no incoming or outgoing connection is used during the match (no SSH, no remote command).
  3. List the buttons, switches and remote controls: none must be able to start the match.

Acceptance criteria:

- C1 In match mode, the RPi’s Wi-Fi and Bluetooth are disabled (or no link to the outside of the table is used).
- C2 Only the cord starts the match; no remote control or start switch.
- C3 No device intended to jam the opponent.

Result:

Sheet F – Functional safety

Sheet F1

Objective: Check that pressing the BAU immediately stops all actuators, whatever their state.

Procedure:

  1. Robot moving at maximum speed in a straight line, pumps running, servomotor moving, launcher rotating (if present).
  2. Strike the BAU. Film the wheel, the floor marker and the button in slow motion.
  3. Measure on the video the time between the press and the complete stop, and the distance traveled after the press.
  4. With the BAU pressed: measure the voltage at the terminals of the motors, pumps, servomotors and launcher.
  5. Repeat 5 times, including one in reverse and one in lateral movement.

Acceptance criteria:

- C1 Complete stop ≤ 500 ms after the press (I1 FC1), 5 tests out of 5.
- C2 Distance traveled after the press ≤ 3 cm (I1 FC1), 5 tests out of 5.
- C3 Zero voltage (< 0.5 V) on all actuators with the BAU pressed; only the control, the display and the avoidance may remain powered.
- C4 The pumps stop (the held element may fall: check that the fall is harmless).

Result:

Sheet F2

Objective: Prove that the BAU cuts the power even if the software has crashed or is commanding the motors.

Procedure:

  1. Robot on blocks, flash the test program: the 4 wheels turn continuously.
  2. Strike the BAU: observe the wheels, measure the voltage at the motor terminals.
  3. Examine the schematic: does the BAU cut a power circuit (relay, contactor, direct cut)?

Acceptance criteria:

- C1 The wheels stop and the motor voltage is zero despite the software command.
- C2 The schematic shows a physical cut of the actuators’ power supply, with no dependence on the software.

Result:

Sheet F3

Objective: Check the starting device: length, reliability, absence of false starts.

Procedure:

  1. Measure the length of the cord.
  2. Set up and pull the cord 20 times in a row (10 per color); measure on video the delay between removal and the start of movement.
  3. False-start tests, cord inserted: tap the robot, vibrate the table, push the robot by 1 cm, pull the cord halfway, unplug/replug the pull-cord connector.
  4. Start the robot without the cord inserted.

Acceptance criteria:

- C1 Cord ≥ 510 mm (limit 500 mm), completely detached from the robot after pulling.
- C2 20 starts out of 20, each ≤ 500 ms after removal (internal requirement).
- C3 0 false starts during the disturbance tests (debounced reading, positive contact).
- C4 Without the cord at power-on, the robot does not start and signals it (indicator light) – internal arming requirement.
- C5 Device easily accessible with the robot in the starting zone, without touching the robot to pull.

Result:

Sheet F4

Objective: Check that the robot stops and switches off all its actuators at the end of the 100 s, whatever the situation.

Procedure:

  1. Case A – normal match: measure the instant of complete stop (wheels and actuators).
  2. Case B – robot blocked by an obstacle (avoidance) between 90 and 100 s.
  3. Case C – robot in full action at 99 s (pump active, servo moving, launcher rotating).
  4. Case D – RPi strategy process saturated or blocked (simulated) before 100 s.
  5. After the stop, observe the robot for 60 s.
  6. 3 tests per case.

Acceptance criteria:

- C1 In all cases, wheels stationary and actuators (motors, pumps, servos, launcher) powered off at the latest 99.8 s after the cord is removed.
- C2 No movement during the following 60 s; only the displays may remain lit.
- C3 The countdown starts at the removal of the cord (not at power-on).
- C4 12 tests out of 12 compliant.

Result:

Sheet F5

Objective: Map what the sensors see and prove that there is no blind spot in the directions of travel.

Procedure:

  1. Robot stationary. For each face: move O1 across a grid in front of the face, from 5 to 60 cm and laterally over the full width of the robot + 10 cm on each side; note detected / not detected at the stopping threshold.
  2. Repeat with O2 (PAMI: low and narrow) and with the soft variant of O1.
  3. Repeat for the 4 diagonals (the omnidirectional robot can move diagonally).
  4. Draw the coverage map (top-view diagram) and archive it.

Acceptance criteria:

- C1 For each direction of travel used by the strategy, O1 and O2 placed anywhere in the corridor swept by the robot (robot width + 5 cm on each side) are detected at a distance ≥ the stopping distance measured in F-09.
- C2 The soft variant of O1 is also detected (otherwise: additional sensor).
- C3 Coverage map archived.

Results:

Sheet F6

Objective: Check that the robot stops without contact in front of an obstacle, at maximum speed, in all directions.

Procedure:

  1. Place O1 on the path, at 1 m. Launch the robot at maximum speed toward the obstacle.
  2. Measure the remaining distance between robot and obstacle after the stop.
  3. Repeat forward, backward, lateral left and right, and in the 4 diagonals; then with O2.

Acceptance criteria:

- C1 No contact with the obstacle: 10 tests out of 10 per direction with O1, 5 out of 5 with O2.
- C2 Remaining distance ≥ 5 cm in all tests (internal requirement).

Result:

Sheet F7

Objective: Check the reaction when the opponent moves toward the robot.

Procedure:

  1. Robot moving forward: push O1 in front of it (head-on collision).
  2. Robot moving: bring O1 in from the side into its travel corridor.
  3. Robot stationary: approach O1 from each face.

Acceptance criteria:

- C1 In each scenario, the robot stops advancing toward the obstacle before contact (5 tests out of 5 per scenario).
- C2 Delay between the obstacle entering the detection zone and the stop ≤ 300 ms (video).
- C3 Robot stationary: it does not start moving toward the obstacle.

Result:

Sheet F8

Objective: Check that the robot stays stopped (without jerks) as long as the obstacle is there, then resumes cleanly.

Procedure:

  1. Cause a stop in front of O1, then leave O1 in place for 30 s.
  2. Remove O1 and measure the resumption delay.

Acceptance criteria:

- C1 No movement of more than 1 cm toward the obstacle and no on/off oscillation for 30 s.
- C2 Resumption (or bypass) ≤ 3 s after the obstacle is removed.

Result:

Sheet F9

Objective: Check that sensor masking never amounts to disabling avoidance (grounds for disqualification).

Procedure:

  1. Check that all sensors are active when the ESP32 starts up.
  2. List in the code every situation where a mask is sent, with its justification (e.g. sensor facing the border or its own construction during a final approach).
  3. Analyze the logs of 5 matches: duration and context of each masking.
  4. Cut the RPi link while a mask is active: check the state of the masks.

Acceptance criteria:

- C1 At start-up and after any loss of link, all sensors are active.
- C2 Never more than one sensor masked at the same time and never the sensor facing the direction of travel, except for a slow final approach (≤ 0.1 m/s) toward a known fixed element, over ≤ 15 cm.
- C3 Each mask is lifted automatically ≤ 1 s after the maneuver; each case is justified in writing.
- C4 The convention (1 = sensor ignored) is identical in the ESP32 code, the RPi code and the documentation.

Result:
