RobotekOrleans/CFR2027/Hardware/Tests/Hardware Validation Test Protocol.odt

Validation Matérielle & Liaisons Bas Niveau

Objectif : Valider l'intégrité du câblage, des liaisons de communication et du fonctionnement individuel des actionneurs, communication UART entre la Raspberry Pi4 et l’ESP32 WROOM32.

1. Test de Communication UART (Raspberry Pi 4 ⟷ ESP32) :

Étape de test | Procédure d'exécution | Résultat attendu | Statut
Émission Raspberry ESP32 | Envoyer une trame depuis la Raspberry Pi sous la forme : <V,100,50, 100, 50> Et <I,0,0, 0, 1> | L'ESP32 réceptionne la trame, la découpe et réparties les données dans les variables correspondantes. Et affiche les valeurs extraites sur son terminal série en précisant le capteur ou le moteur correspondant à la valeur reçu. Exemple : MoteurAvantDroit : 50 CapteurAvant : activé
Émission ESP32 Raspberry | Envoyer une trame de télémétrie depuis l'ESP32 de la forme <US,38.9,12.0, 42, 45>. | La Raspberry Pi reçoit la trame, la découpe et réparties les données dans les variables correspondantes. Et affiche les valeurs extraites dans la console Python en précisant le capteur correspondant et la valeur reçu. Exemple CapteurAvant : 20 cm
Contrôle d'intégrité | Transmettre une série de 100 trames consécutives dans les deux sens. | Aucune perte de caractère, aucune corruption de structure (trames tronquées ou altérées).

2. Test des Capteurs Ultrasons :

Étape de test | Procédure d'exécution | Résultat attendu | Statut
Mesure d'étalonnage | Placer un obstacle fixe à des distances connues (50 cm, 10 cm, 15 cm) face à chaque capteur. | La valeur renvoyée par le code correspond à la distance réelle à près.
Répartition des voies | Déclencher les 4 capteurs un par un de manière séquentielle. | Chaque capteur répond indépendamment sans interférence ni lecture croisée sur un autre port ECHO.
Gestion des dépassements | Pointer le capteur vers le vide. | Le code ne bloque pas l'exécution du programme.

3. Test de la Chaîne Motorisation :

Étape de test | Procédure d'exécution | Résultat attendu | Statut
Sens de rotation & PWM | Appliquer un signal PWM de 100 puis 150 puis 200 successivement sur chaque moteur. | Les moteurs tournent dans le sens voulu et la vitesse visuelle augmente proportionnellement au PWM.
Retour encodeurs | Faire tourner chaque roue 5 fois à la main puis via le moteur. | L'ESP32 comptabilise les impulsions sur les interruptions et renvoie que les moteurs ont tournées 5 fois.
Cohérence PWM | Envoyer une consigne PWM de 100 et mesurer le retour de l'encodeur. | L’encodeur renvoi le PWM réel du moteur, il doit être de 100 ± 5
