RobotekOrleans/CFR2027/Hardware/PCB/Shematics for ultra-sound sensor.pdf

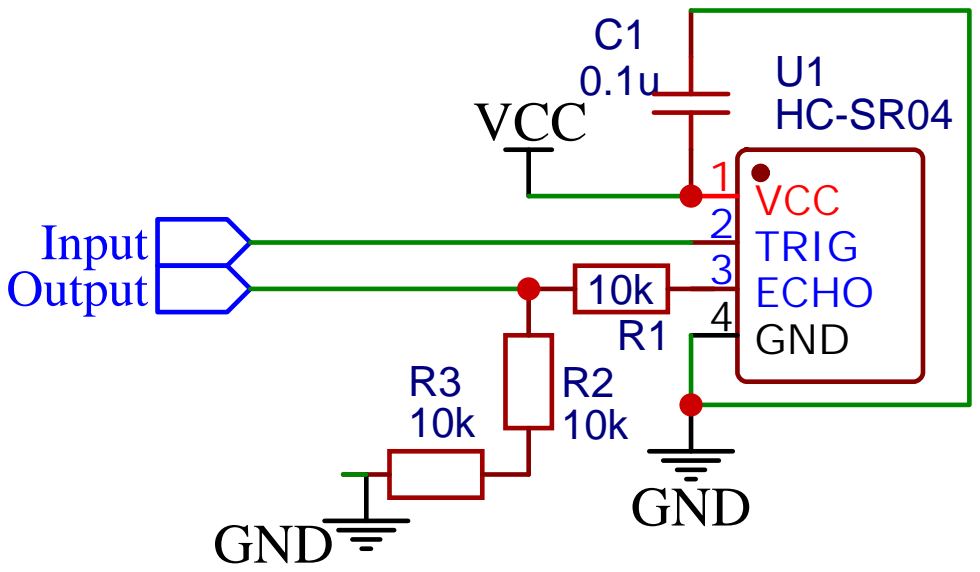
[picture p14: page 1]
