RobotekOrleans/CFR2027/(commit log)

2026-10-20 feat: ajout du dossier Software avec le code ESP32
2026-10-20 refactor: placement des fichiers directement dans Software
2026-10-20 finalistation de l'orga
2026-10-21 Ajout code de test ultrasons
2026-10-21 Add of Battery holder 3D file
2026-10-21 update of CAD
